JohnOpenXC/retro-gauge/schematics/Gauge-BOM.xls

Ford Motor Company | SVL |  |  |  |  | Please call to confirm any issues or questions before proceeding
BOM:RGAUGE Rev 2.0
Date:12/12/2012
Assignee: Dave Evans (650) 332-4611
Item | SPE part # | Qty/ bd | Reference desig. | Customer part # | Value | Footprint | Description / Extended specs | Mnfr or vendor description/ specs | Manfr. | Manf part # | Distributor | Distributor P/N | Unit Price ($) | Total ($)
1 |  | 2 | SHIFT1, SHIFT2 |  |  | 16-SOIC (0.154", 3.90mm Width) | IC 8BIT SHIFT REG 3ST-OUT 16SOIC | IC 8BIT SHIFT REG 3ST-OUT 16SOIC | Texas Instruments | SN74HC595DR | DIGIKEY | 296-14857-1-ND | 0.59 | $1.18
2 |  | 14 | R1,R2,R3,R4,R5,R6,R7,R8,R9,R10,R11,R12,R13,R14 |  | 220 | SM/R_1206 | RES 220 OHM 1/4W 5% 1206 SMD | RES 220 OHM 1/4W 5% 1206 SMD | Panasonic Electronic Components | ERJ-8GEYJ221V | DIGIKEY | P220ETR-ND | $0.10 | $1.40
3 |  | 6 | R15,R16,R17,R20,R21,R22 |  | 100 | SM/R_1206 | RES 100 OHM 1/4W 5% 1206 SMD | RES 100 OHM 1/4W 5% 1206 SMD | Panasonic Electronic Components | ERJ-8GEYJ101V | DIGIKEY | P100ETR-ND | $0.10 | $0.60
4 |  | 2 | LED1, LED2 |  | RGB LED | 15-21B SMD | Triple Output LED RGB - SMD | Triple Output LED RGB - SMD | - | - | Sparkfun | COM-07844 | $1.80 | $3.60
5 |  | 1 | ARUDINO_MINI |  | ARDUINO_MINI | - | ARDUINO PRO MINI | Arduino Pro Mini 328 - 5V/16MHz | Arduino | - | Sparkfun | DEV-11113 | $7.95 | $7.95
6 |  | 2 | Female Header |  | - | M09 | CONN HEADER FEM 9POS .1" SGL GLD | CONN HEADER FEM 9POS .1" SGL GLD | PPPC091LFBN | Sullins Connector Solutions | DIGIKEY | S4109-ND | $0.30 | $0.61
7 |  | 1 | M06SIP |  | - | M06 |  |  | Generic | - | Sparkfun | PRT-00116 | $1.20 | $1.20
8 |  | 1 | VID29 |  | - | VID29-07 | VID29 | VID29 series stepper motor | VID | VID29-07 | Ebay | link (http://www.ebay.com/itm/100pcs-New-instrument-Cluster-Stepper-motor-vid29-05-/300673452272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) | $5.63 | $5.63 | *Note: Ebay sells at VID29-05 but the form factor is the VID29-07
9 |  | 4 | Screws |  | - | - | - | Thrd-Forming 18-8SS Screw for Brittle Plastic Pan Head, 6-19 Thread, 3/8" Length | McMaster | 97349A200 | McMaster | http://www.mcmaster.com/#catalog/119/3008/=m5f3r4 | $0.06 | $0.24
10 |  | 1 | FTDI Chip |  | - | FTDI | FTDI Breakout board | FTDI Basic Breakout - 5V | Sparkfun | DEV-09716 | Sparkfun | DEV-09716 | $11.96 | $11.96 | *Note: Ebay sells at VID29-05 but the form factor is the VID29-07
 |  |  |  |  |  |  |  |  |  |  |  | TOTAL COST: |  | $34.37
