JohnOpenXC/retro-gauge/firmware/firmware.ino

#include <SwitecX25.h>


//-----------------------RGB Variables-----------------------------------//
int LED_RED = 11;
int LED_BLUE = 10;
int LED_GREEN = 9;
int rgbValue = 0;
int light;


//-----------------------Motor Variables--------------------------------//

// standard X25.168 range 315 degrees at 1/10 degree steps
#define STEPS (315*3)

int m1 = 8; //pin 8
int m2 = 7; //pin 7
int m3 = 5; //pin 5
int m4 = 6; //pin 6
static int nextPos;

// For motors connected to pins 8,7,5,6
SwitecX25 motor1(STEPS,m1,m2,m3,m4);

//Serial vars
String input = "";
int ledVal = 0;
long motorVal = 0;

//-----------------------Display Variables-------------------------------//
const byte LED_CHAR_SET[10] = {
  B11111100,B01100000,B11011010,B11110010, //0,1,2,3
  B01100110,B10110110,B10111110,B11100000, //4,5,6,7
  B11111110,B11100110};                    //8,9

const byte NONE[1] = {
  B00000000};

int numToSend = 0;
int tenDigit = 0;
int singleDigit = 0;

const int dataPin  = 4;  // Pin connected to Pin 14 of 74HC595 (Data)
const int clockPin = 2;  // Pin connected to Pin 11 of 74HC595 (Clock)
const int latchPin = 3;  // Pin connected to Pin 12 of 74HC595 (Latch)

int ten = 0;
int one = 0;

//-----------------------Update Variables-------------------------------//
int time = 0;
int digitUpdate = 1000; //1 Sec
unsigned long motorPer;
int speedSlope = 1739;
long targetPosition = 0;
long currentPosition = 0;
unsigned long nextUpdate;
long delta;


void setup(void) {
  Serial.begin(9600);
  Serial.print("Go time!");

  //Zero the position, bring needle to 50%, set to zero  
  motor1.zero();


  //Display
  pinMode(latchPin, OUTPUT);
  pinMode(clockPin, OUTPUT);
  pinMode(dataPin, OUTPUT);
  clearDisplay();

  pinMode(LED_RED, OUTPUT);
  pinMode(LED_BLUE, OUTPUT);
  pinMode(LED_GREEN, OUTPUT);

  nextUpdate = micros();
}

void loop() {  
  delta = targetPosition - currentPosition;
  if (micros() > nextUpdate) {
    if((delta) > 0) {
      motor1.stepUp();
      currentPosition++;
    } else if(delta < 0){
      motor1.stepDown();
      currentPosition--;
    }
//    nextUpdate += 6290 - 10*abs(targetPosition - currentPosition);
    if (delta != 0) {
      nextUpdate = micros() + 400 + 279841/(abs(delta));
    }
  }

  if (Serial.available()) {

    while (Serial.available() > 0){
      char c = Serial.read();
      input += c;

      if (c == ')' || c =='>'){
        parse_message(input);
        input = "";
//        long delta = abs(targetPosition - currentPosition);
//        if (delta == 0) {
//          nextUpdate = 1000000000;
//        } else {
//          nextUpdate = micros() + 400 + 279841/(delta);
//        }
      }
      if (c == 'u') {
        motor1.stepUp();
      }
      if (c == 'd') {
        motor1.stepDown();
      }
    }
  }
}

void parse_message(String message) {
  for (int i = 0; i <= message.length(); i++) {
    time = millis();
    if (message[i] == '(') {
      motorVal = 10*(message[i+1]-'0') + (message[i+2]-'0');
      motorPer = motorVal*1000/speedSlope;
      //motor1.setPosition(STEPS*motorPer/100);
      targetPosition = STEPS*motorPer/100;
     
      //Update Digits
      setDisplay(LED_CHAR_SET[motorVal/10],LED_CHAR_SET[motorVal%10]);

//      Serial.print("Motor % = ");
//      Serial.println(motorVal);
    }
    
 
    if (message[i] == '<') {
      rgbValue = 100*(message[i+1] -'0') + 10*(message[i+2]-'0') + (message[i+3]-'0');
//    Serial.println(rgbValue);
      light = 100*(message[i+4] -'0') + 10*(message[i+5]-'0') + (message[i+6]-'0');
      setLED(rgbValue, 255);
    }
  }
}

void clearDisplay() {
  //Prepare 595 to received data
  digitalWrite(latchPin, LOW); 
  //Shift data to 595
  shiftOut(dataPin, clockPin, LSBFIRST, NONE[1]);
  shiftOut(dataPin,clockPin, LSBFIRST, NONE[1]);
  //Set latch to high to send data
  digitalWrite(latchPin, HIGH);
}



void setDisplay(byte display1, byte display2) {
  //Prepare 595 to received data
  digitalWrite(latchPin, LOW); 
  //Shift data to 595
  shiftOut(dataPin, clockPin, LSBFIRST, display2);
  shiftOut(dataPin, clockPin, LSBFIRST, display1);
  //Set latch to high to send data
  digitalWrite(latchPin, HIGH);
}

void setLED(int hue, int l){
  int col[3] = {
    0,0,0  };
  getRGB(hue, 255, l, col);
  ledWrite(col[0], col[1], col[2]);
}

void getRGB(int hue, int sat, int val, int colors[3]) {
  // hue: 0-259, sat: 0-255, val (lightness): 0-255
  int r, g, b, base;

  if (sat == 0) { // Achromatic color (gray).
    colors[0]=val;
    colors[1]=val;
    colors[2]=val;
  } 
  else  {
    base = ((255 - sat) * val)>>8;
    switch(hue/60) {
    case 0:
      r = val;
      g = (((val-base)*hue)/60)+base;
      b = base;
      break;
    case 1:
      r = (((val-base)*(60-(hue%60)))/60)+base;
      g = val;
      b = base;
      break;
    case 2:
      r = base;
      g = val;
      b = (((val-base)*(hue%60))/60)+base;
      break;
    case 3:
      r = base;
      g = (((val-base)*(60-(hue%60)))/60)+base;
      b = val;
      break;
    case 4:
      r = (((val-base)*(hue%60))/60)+base;
      g = base;
      b = val;
      break;
    case 5:
      r = val;
      g = base;
      b = (((val-base)*(60-(hue%60)))/60)+base;
      break;
    }
    colors[0]=r;
    colors[1]=g;
    colors[2]=b;
  }
}

void ledWrite(int r, int g, int b){
  analogWrite(LED_RED, 255-r);
  analogWrite(LED_GREEN, 255-g);
  analogWrite(LED_BLUE, 255-b);
}
