JohnOpenXC/retro-gauge/(commit log)

2013-02-07 cleaned up 'nextUpdate' and timing issues
    [firmware.ino]
2013-04-01 added FTDI chip to board
2013-04-02 layout completed for V3
    [GaugeRev2.brd, GaugeRev2.sch]
2013-04-17 updated schematics
    [Gauge-BOM-V3.xls, Gauge-BOM-v2.xls, GaugeRev3.brd, GaugeRev3.sch]
2013-04-17 Updated BOM
    [Gauge-BOM.xls]
